Starman3787/btc-split-flap/hardware/cut_layouts/all_400x600.dxf

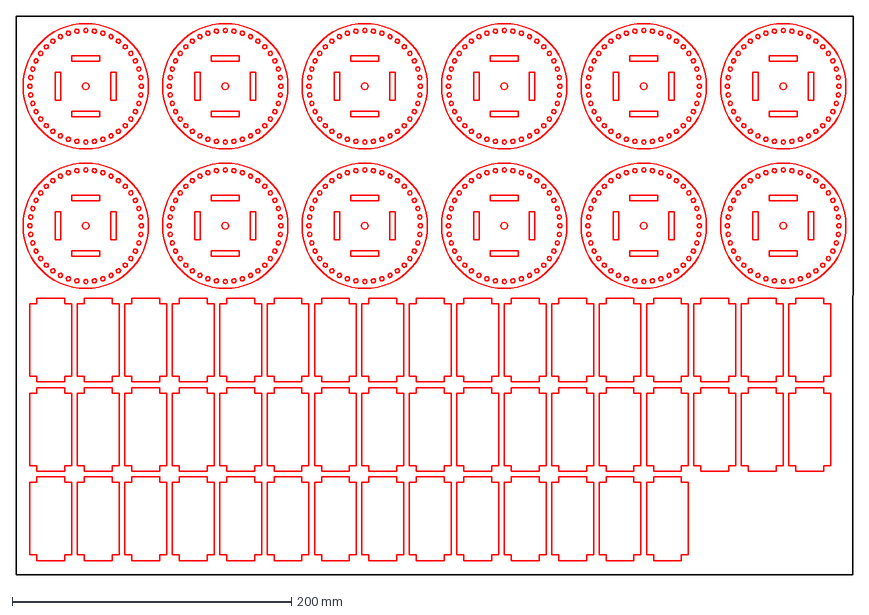
[picture p1: CAD file, 2024-01-09]
hardware/cut_layouts/all_400x600.dxf
600.0 x 400.0 mm
