Starman3787/btc-split-flap/hardware/parts/base_front_panel.dxf

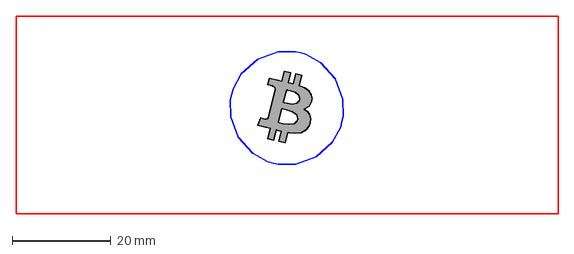
[picture p2: CAD file, 2021-07-17]
hardware/parts/base_front_panel.dxf
110.0 x 40.0 mm
