Starman3787/btc-split-flap/hardware/cut_layouts/all_base_panels.dxf

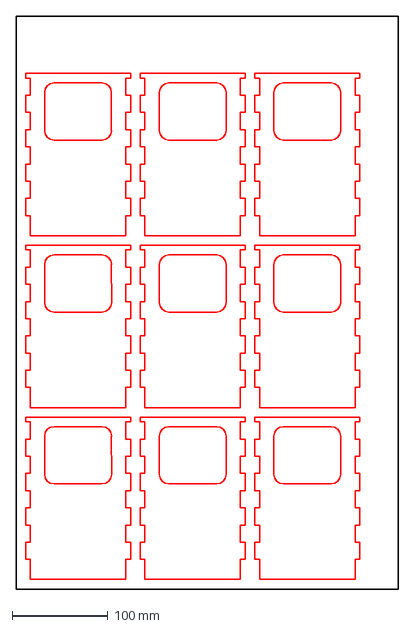
[picture p3: CAD file, 2024-01-09]
hardware/cut_layouts/all_base_panels.dxf
400.0 x 600.0 mm
