Starman3787/btc-split-flap/hardware/parts/base.dxf

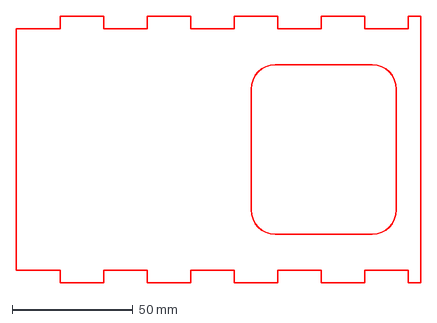
[picture p4: CAD file, 2021-07-12]
hardware/parts/base.dxf
167.0 x 110.0 mm
