Starman3787/btc-split-flap/hardware/cut_layouts/all_other_module_parts.dxf

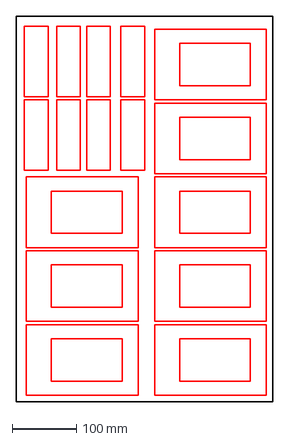
[picture p5: CAD file, 2024-01-09]
hardware/cut_layouts/all_other_module_parts.dxf
400.0 x 600.0 mm
