Starman3787/btc-split-flap/hardware/parts/base_back_panel.dxf

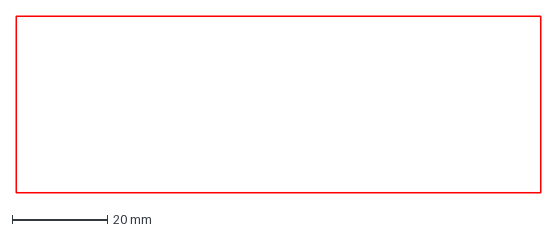
[picture p6: CAD file, 2021-07-12]
hardware/parts/base_back_panel.dxf
110.0 x 37.0 mm
