Starman3787/btc-split-flap/hardware/cut_layouts/all_base_box_panels.dxf

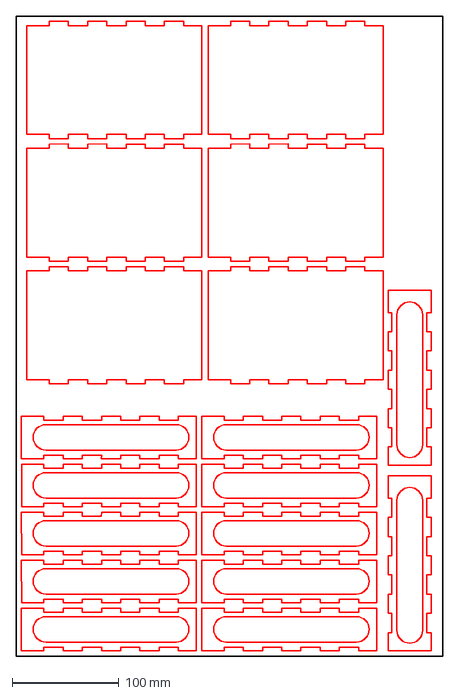
[picture p7: CAD file, 2021-07-12]
hardware/cut_layouts/all_base_box_panels.dxf
400.0 x 600.0 mm
