Starman3787/btc-split-flap/hardware/parts/base_base.dxf

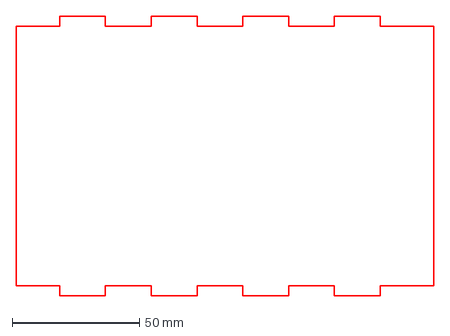
[picture p8: CAD file, 2021-07-12]
hardware/parts/base_base.dxf
164.0 x 110.0 mm
