Starman3787/btc-split-flap/hardware/cut_layouts/all_front_base_panels.dxf

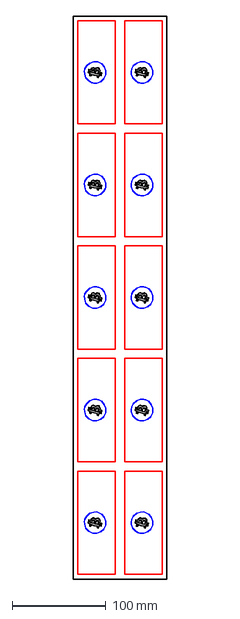
[picture p9: CAD file, 2021-07-12]
hardware/cut_layouts/all_front_base_panels.dxf
100.0 x 600.0 mm
