Starman3787/btc-split-flap/hardware/parts/base_side_panel.dxf

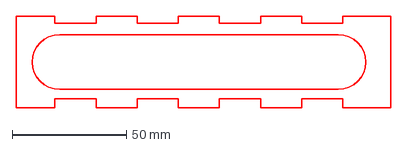
[picture p10: CAD file, 2021-07-12]
hardware/parts/base_side_panel.dxf
164.0 x 40.0 mm
