Starman3787/btc-split-flap/hardware/cut_layouts/extra_tops.dxf

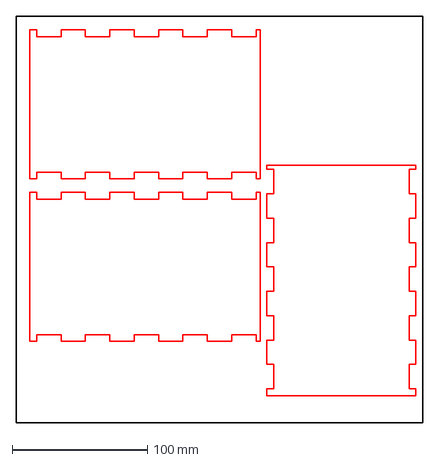
[picture p11: CAD file, 2021-07-12]
hardware/cut_layouts/extra_tops.dxf
300.0 x 300.0 mm
