Starman3787/btc-split-flap/hardware/parts/front_panel.dxf

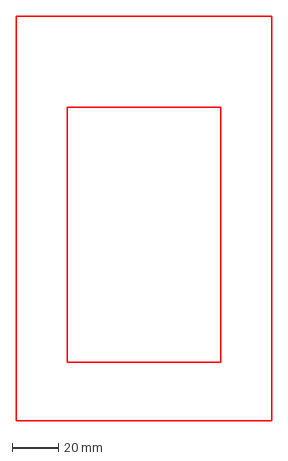
[picture p12: CAD file, 2021-07-12]
hardware/parts/front_panel.dxf
110.0 x 174.0 mm
