Starman3787/btc-split-flap/hardware/parts/top.dxf

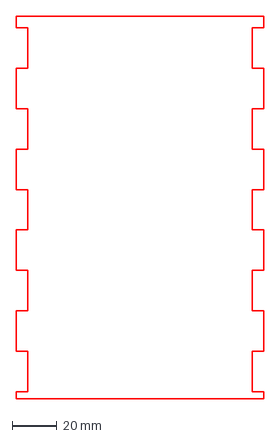
[picture p13: CAD file, 2021-07-11]
hardware/parts/top.dxf
110.0 x 170.0 mm
