Starman3787/btc-split-flap/hardware/cut_layouts/module_casing_v1.dxf

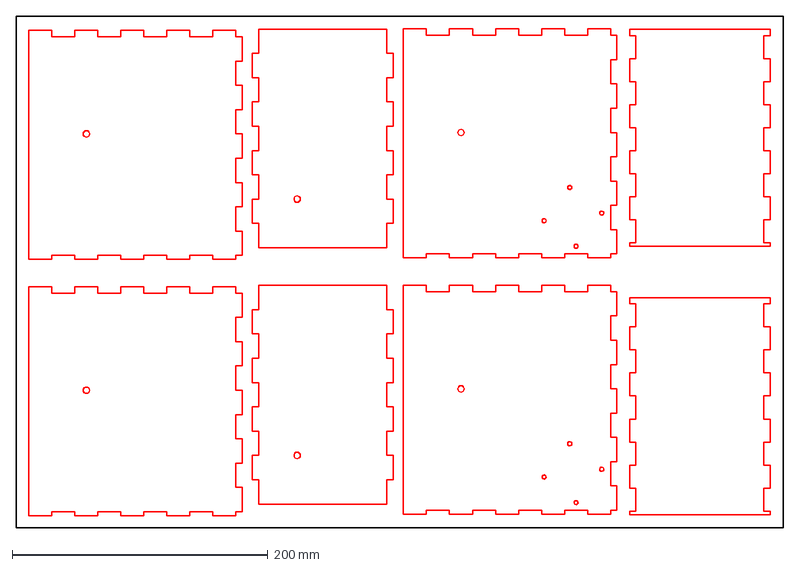
[picture p14: CAD file, 2021-06-30]
hardware/cut_layouts/module_casing_v1.dxf
600.0 x 400.0 mm
