Starman3787/btc-split-flap/hardware/parts/side_panel_left.dxf

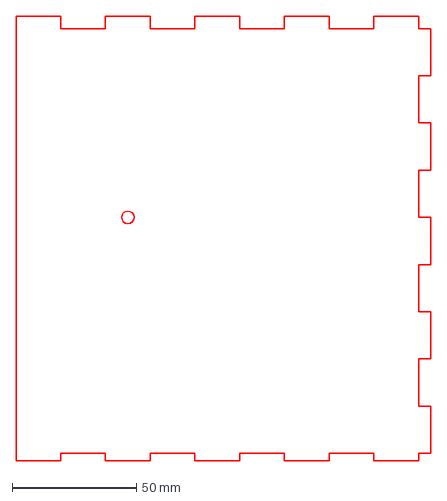
[picture p15: CAD file, 2021-06-25]
hardware/parts/side_panel_left.dxf
167.0 x 179.0 mm
