Starman3787/btc-split-flap/hardware/cut_layouts/spool_attachments.dxf

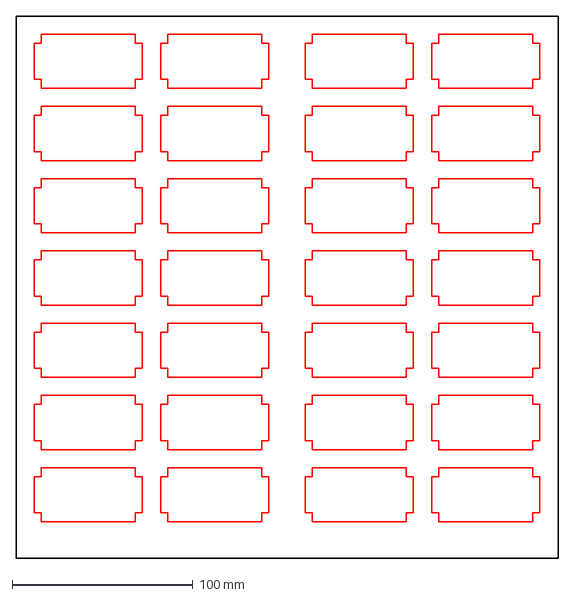
[picture p16: CAD file, 2021-06-25]
hardware/cut_layouts/spool_attachments.dxf
300.0 x 300.0 mm
