Starman3787/btc-split-flap/hardware/parts/back_panel.dxf

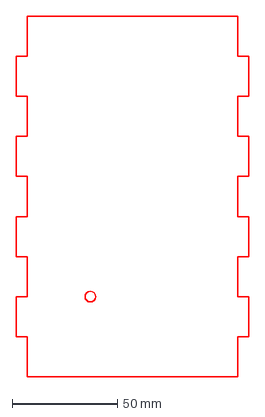
[picture p17: CAD file, 2021-06-25]
hardware/parts/back_panel.dxf
110.0 x 171.0 mm
