Starman3787/btc-split-flap/hardware/parts/side_panel_right.dxf

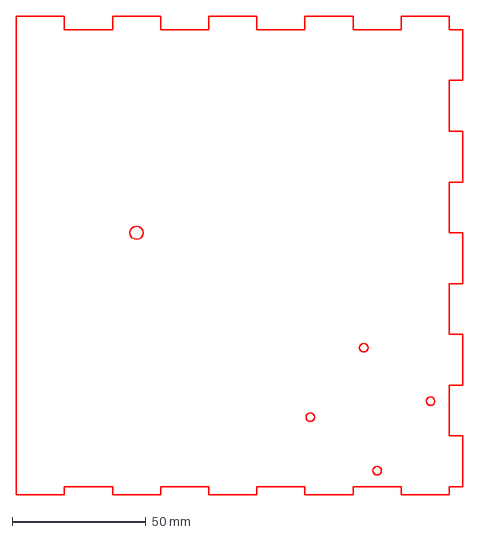
[picture p18: CAD file, 2021-06-25]
hardware/parts/side_panel_right.dxf
167.0 x 179.0 mm
