Starman3787/btc-split-flap/hardware/parts/spool_attachment.dxf

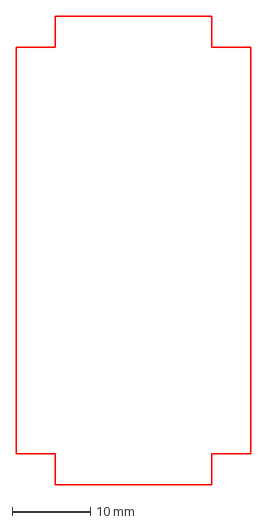
[picture p19: CAD file, 2021-05-29]
hardware/parts/spool_attachment.dxf
30.0 x 60.0 mm
