Starman3787/btc-split-flap/hardware/parts/spool.dxf

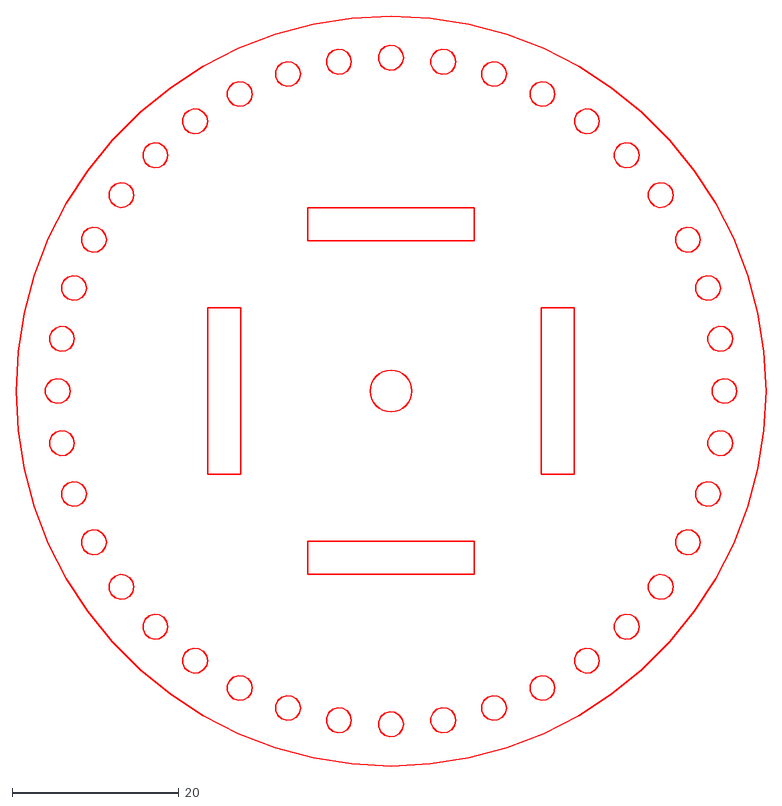
[picture p20: CAD file, 2021-05-22]
hardware/parts/spool.dxf
90.0 x 90.0
