Starman3787/btc-split-flap/hardware/parts/flap.dxf

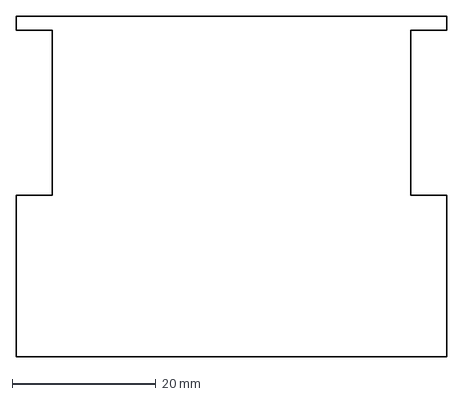
[picture p21: CAD file, 2021-05-10]
hardware/parts/flap.dxf
60.0 x 47.5 mm
