Starman3787/btc-split-flap/hardware/electronics/teststm/btctestv0/btctestv0.kicad_pcb

## KiCad design hardware/electronics/teststm/btctestv0/btctestv0.kicad_pcb (2021-10-17)

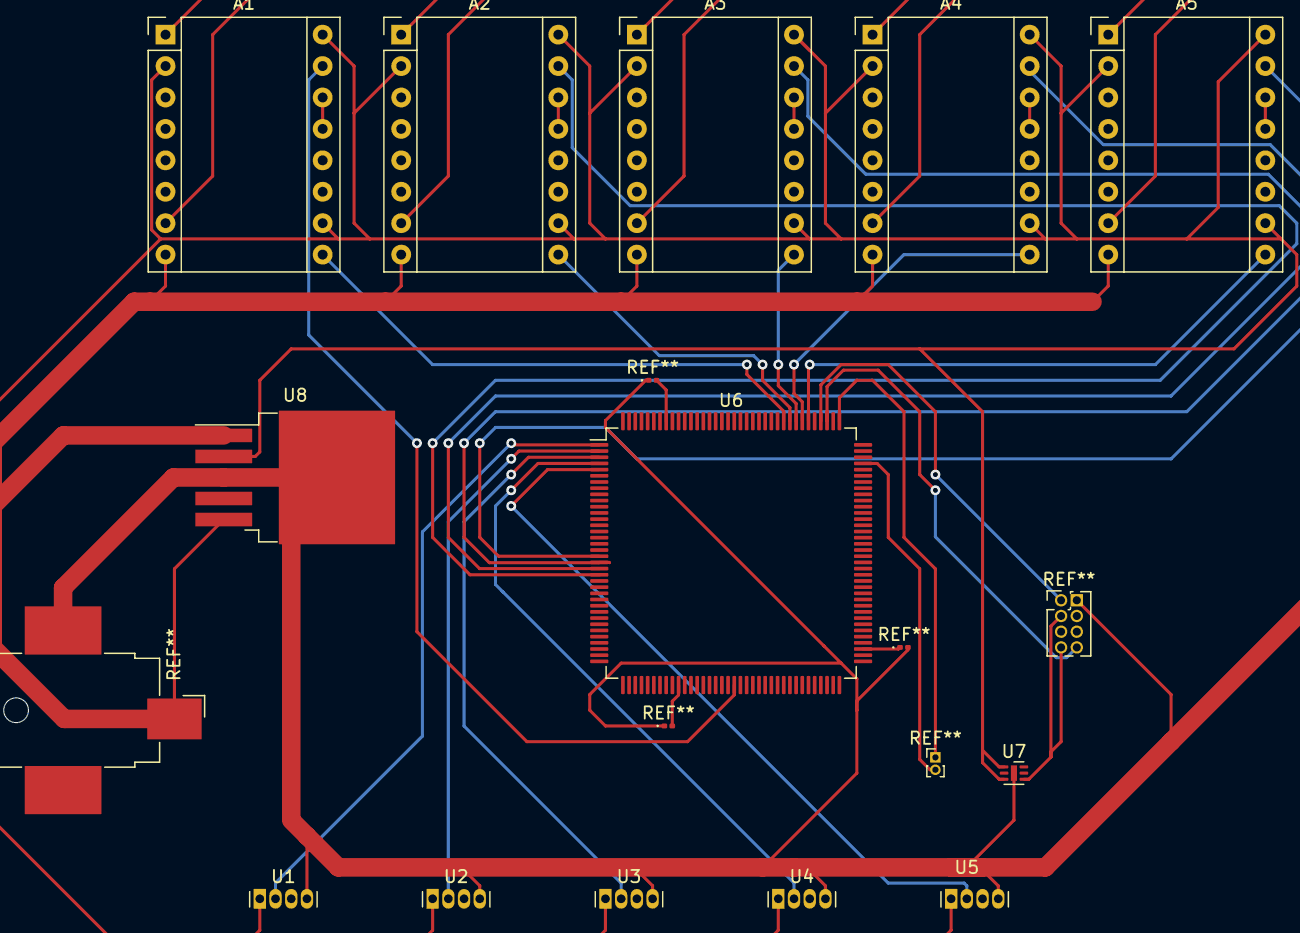
[picture p22: board btctestv0.kicad_pcb from above]

Board: 2 copper layers, 13 parts (0 on the bottom side), 23 nets.

Parts:
A1, A2, A3, A4, A5: Pololu_Breakout_A4988; Pololu_Breakout-16_15.2x20.3mm
U1, U2, U3, U4, U5: A1363xKTTN-1; Allegro_SIP-4
U6: STM32F767ZITx; LQFP-144_20x20mm_P0.5mm
U7: MIC5353-3.3YMT; MLF-6-1EP_1.6x1.6mm_P0.5mm_EP0.5x1.26mm
U8: GL2576-5.0TA5R; TO-263-5_TabPin3

Connections:
+5V: A1.2, A1.10, A1.16, A2.2, A2.10, A2.16, A3.2, A3.10, A3.16, A4.2, A4.10, A4.16, A5.2, A5.10, A5.16, U1.1, U2.1, U3.1, U4.1, U5.1, U7.1, U7.3, U8.2
+12V: A1.8, A2.8, A3.8, A4.8, A5.8, U8.1, U8.5
GND: A1.1, A1.7, A2.1, A2.7, A3.1, A3.7, A4.1, A4.7, A5.1, A5.7, U1.4, U2.4, U3.4, U4.4, U5.4, U7.2, U7.7, U8.3
HES_0: U1.2, U6.1
HES_1: U2.2, U6.2
HES_2: U3.2, U6.3
HES_3: U4.2, U6.4
HES_4: U5.2, U6.5
MOT_0_EN: A5.9, U6.114
MOT_0_STEP: A5.15, U6.19
MOT_1_EN: A4.9, U6.115
MOT_1_STEP: A4.15, U6.20
MOT_2_EN: A3.9, U6.116
MOT_2_STEP: A3.15, U6.21
MOT_3_EN: A2.9, U6.117
MOT_3_STEP: A2.15, U6.22
MOT_4_EN: A1.9, U6.118
MOT_4_STEP: A1.15, U6.55
unnamed: A1.13, A1.14
unnamed: A2.13, A2.14
unnamed: A3.13, A3.14
unnamed: A4.13, A4.14
unnamed: A5.13, A5.14
