Starman3787/btc-split-flap/(commit log)

2021-05-27 add CMSIS drivers
2021-05-27 add STM32F76 headers
2021-05-27 systick interrupt handler
2021-05-27 add function to toggle motors on and off
2021-05-27 fix hall effect sensor read and init functions
    [hall_effect_sensor.c]
2021-05-27 fix motor enable/disable function
    [motor.c]
2021-05-27 only spin motors if sensor 1 detects a magnet
2021-05-29 update to allow for 6 complete spools with attachments
    [all_400x600.dxf]
2021-05-29 update spool attachment to improve spacing with spools and cards
    [spool_attachment.dxf]
2021-05-29 move pin mappings to header files
2021-06-01 create uart files
2021-06-02 add uart driver
2021-06-02 update hall effect sensor pins
2021-06-02 add uart read and write functions
2021-06-08 call wifi and uart init
2021-06-08 fix careless mistakes and add commenting
    [uart.c]
2021-06-08 add function to read full uart string
2021-06-08 add function to write a sting to the uart
2021-06-09 add additional uart pins for logging
2021-06-09 add led driver
2021-06-09 add extra uart for logging
2021-06-09 add function to read everything received and check it against a provided string, and fixed an issue for writing a full string to uart
    [uart.c]
2021-06-09 fixed an issue for writing full string to uart
    [uart.c]
2021-06-09 init led
2021-06-10 add function to output string over uart for debugging
2021-06-25 make side-specific panels
    [side_panel_left.dxf, side_panel_right.dxf]
2021-06-25 check if parts slot together
    [module_casing.dxf]
2021-06-25 change line colour to red
    [back_panel.dxf, base.dxf, side_panel_left.dxf, side_panel_right.dxf]
2021-06-26 function to toggle an led
2021-06-27 clear ok pin on error
2021-06-30 corrected base/top width
    [base.dxf]
2021-06-30 update to correct top
    [module_casing_v1.dxf]
2021-07-17 rearrange files
    [all_400x600.dxf, all_base_box_panels.dxf, all_base_panels.dxf, all_front_base_panels.dxf, all_other_module_parts.dxf, back_panel.dxf, base.dxf, base_back_panel.dxf]
2021-07-26 prevent initial position from being stuck at 0
    [split_flap.c]
2021-08-03 move find_pattern to uart.c
2021-08-05 account for sensor having larger than intended detection range
2021-09-01 replace leading underscores with trailing underscores
    [esp_01s.h, hall_effect_sensor.h]
2021-09-02 remove more malloc and replace with structures of a fixed size
    [btc.c, esp_01s.c, esp_01s.h]
2021-09-04 cleanup + improve error handling & security
    [btc.c, delay.c, esp_01s.c, esp_01s.h, hall_effect_sensor.c]
2021-10-09 add pcb
    [btctestv0-B_Cu.gbr, btctestv0-B_Mask.gbr, btctestv0-B_Paste.gbr, btctestv0-B_SilkS.gbr, btctestv0-Edge_Cuts.gbr, btctestv0-F_Cu.gbr, btctestv0-F_Mask.gbr, btctestv0-F_Paste.gbr]
2021-10-17 fix some timing issues
    [esp_01s.c]
2022-06-02 improve handling of uart
2024-01-09 update cad
    [all_400x600.dxf, all_base_panels.dxf, all_other_module_parts.dxf, extra_tops_DEPRECATED.dxf, spool_attachments_DEPRECATED.dxf]
